Cosmin080/Oscilator-RC-cu-retea-Wien/P1_2024_431E_Oprea_Cosmin_OW_orCAD.pdf

UNIVERSITATEA NAȚIONALĂ DE ȘTIINȚĂ ȘI TEHNOLOGIE POLITEHNICA DIN BUCUREȘTI Facultatea de Electronică ,Telecomunicații și Tehnologia Informației

### Oscilator RC cu punte Wien

### Student: Oprea Cosmin

### Grupa:431E

### 1)Date de proiectare

- N=18
- Frecventa de oscilatie reglabila ,fo intre 9-54 [KHz]
- Sarcina la iesire RL:18 kΩ
- Amplitudinea de oscilatie la iesire – Vo: 0.74V
- Control automat al amplitudinii de oscilatie realizat cu TEC-J
- Domeniul temperaturilor de functionare: 0°C - 70°C
- Semnalizarea prezenței tensiunilor de alimentare cu diodă de tip LED

### 2)Schema bloc a circuitului

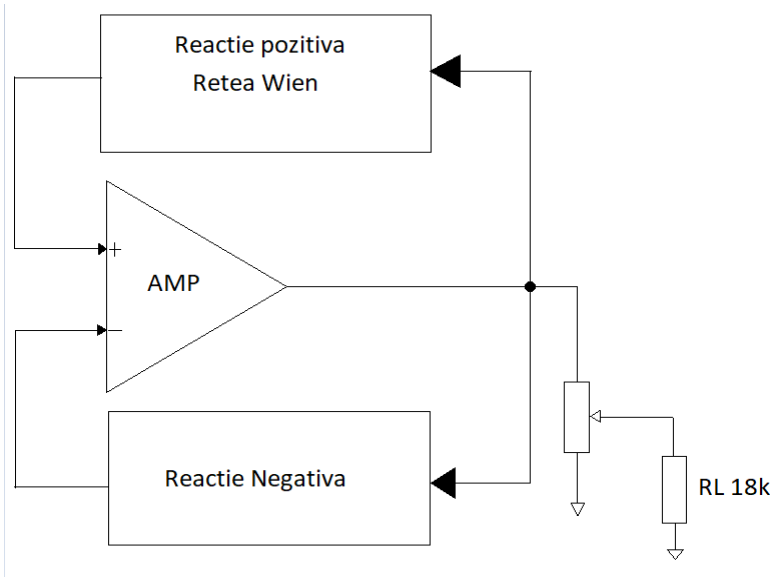
[picture p1: figure]

### 3)Schema oscilatorului

In figura se pot observa componentele oscilatorului:amplificatorul de baza, reactia negativa si puntea Wien.

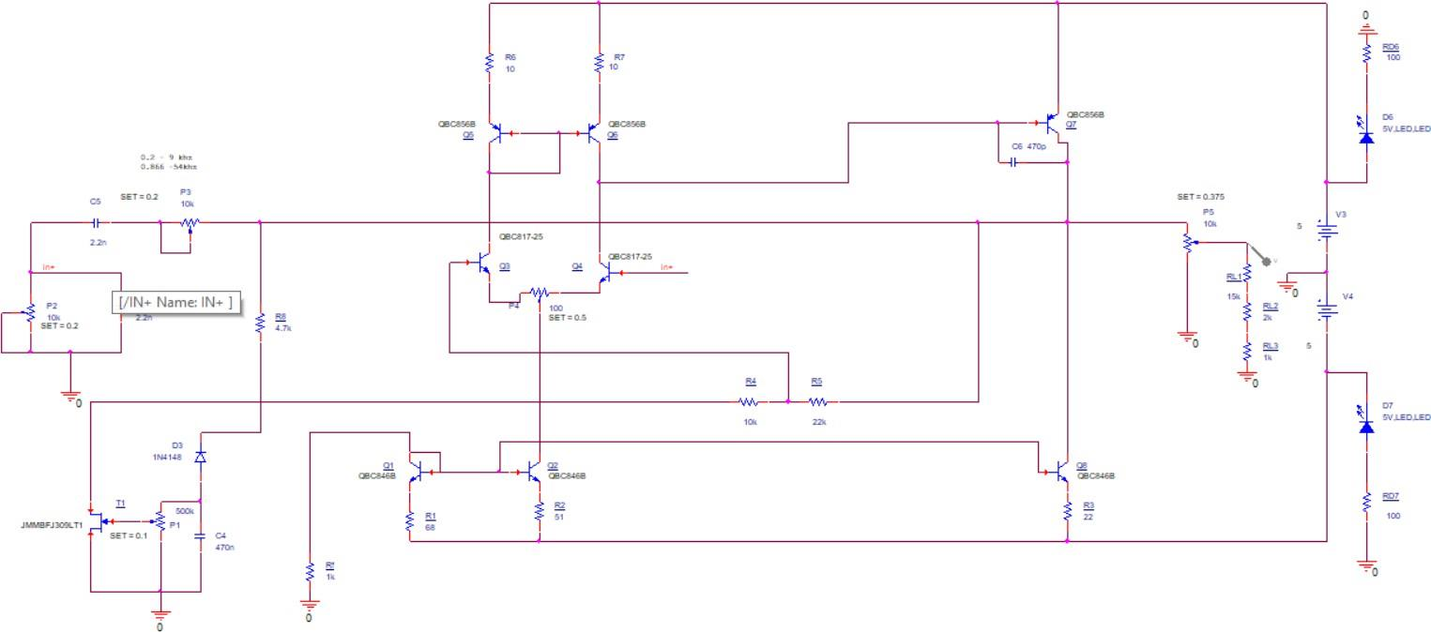
[picture p2: figure]

- Blocurile componente:
− Etaj diferential de intrare format din: Q3 si Q4.
− Etaj de castig in conexiune emitor comun,etaj de amplificare: Q7.
− Capacitate Miller utilizata pentru compensarea in frecventa a amplificatoarelor, manifestandu-se ca o crestere a capacitatii efective prin amplificare: C6.
− Controleaza amplitudinea oscilatiilor: P5.
− Controleaza frecventa de oscilatie: P2 si P3.
− Q5 si Q6 au rolul de a egala curentii pe cele 2 ramuri,Q5 fiind referinta de oglinda.
− P4 balanseaza curentii pentru etajul diferential
− Q8 sursa de curent pentru Q7(emitor comun)
− Curentul de referinta este generat pe latura cu rezista Rf

Proiectarea reactiei pozitive:

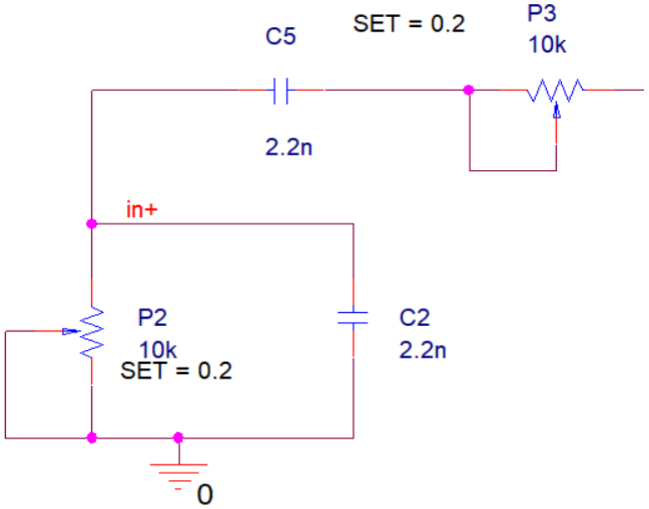
[picture p3: figure]

Formula cu care aflam valoarea frecventei este: fosc=1/(2πRC).

Valorile componentelor au fost alese pentru a acoperi intreaga gama de valori.

Proiectarea reactiei negative:

E constituita din rezistente R5, R4 si rezistenta canalului tranzistorului JFET – T1

Rezistenta canalului lui T1 este un parametru ce se modifica dinamic in functie de amplitudinea oscilatiilor la iesire.

Amplificarea = 1+(R5/(R4+Rds,T1))

4) Simularea oscilatorului
4.1) Punctul static de functionare calculat (teoretic)

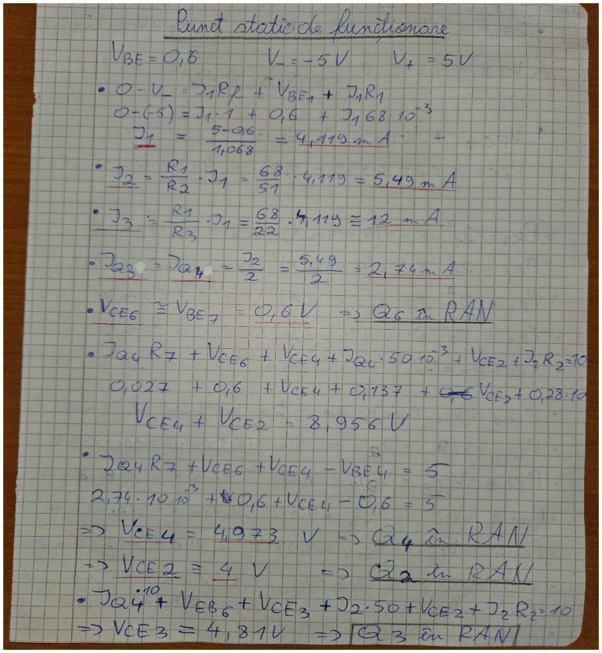
[picture p4: figure]

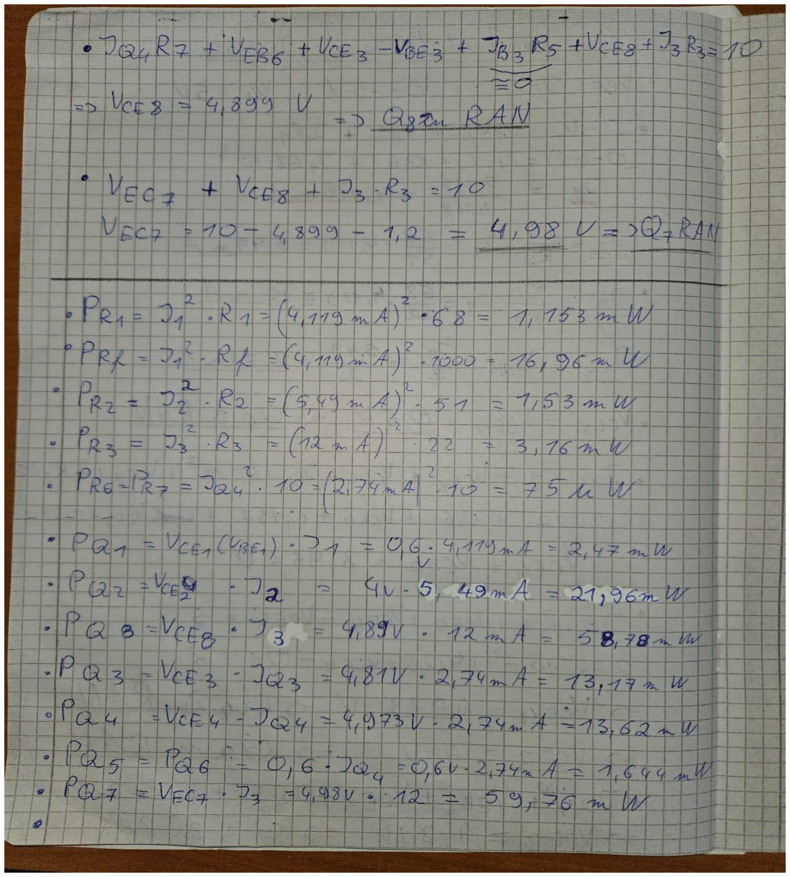
[picture p5: figure]

4.2) Punctul static de functionare simulat

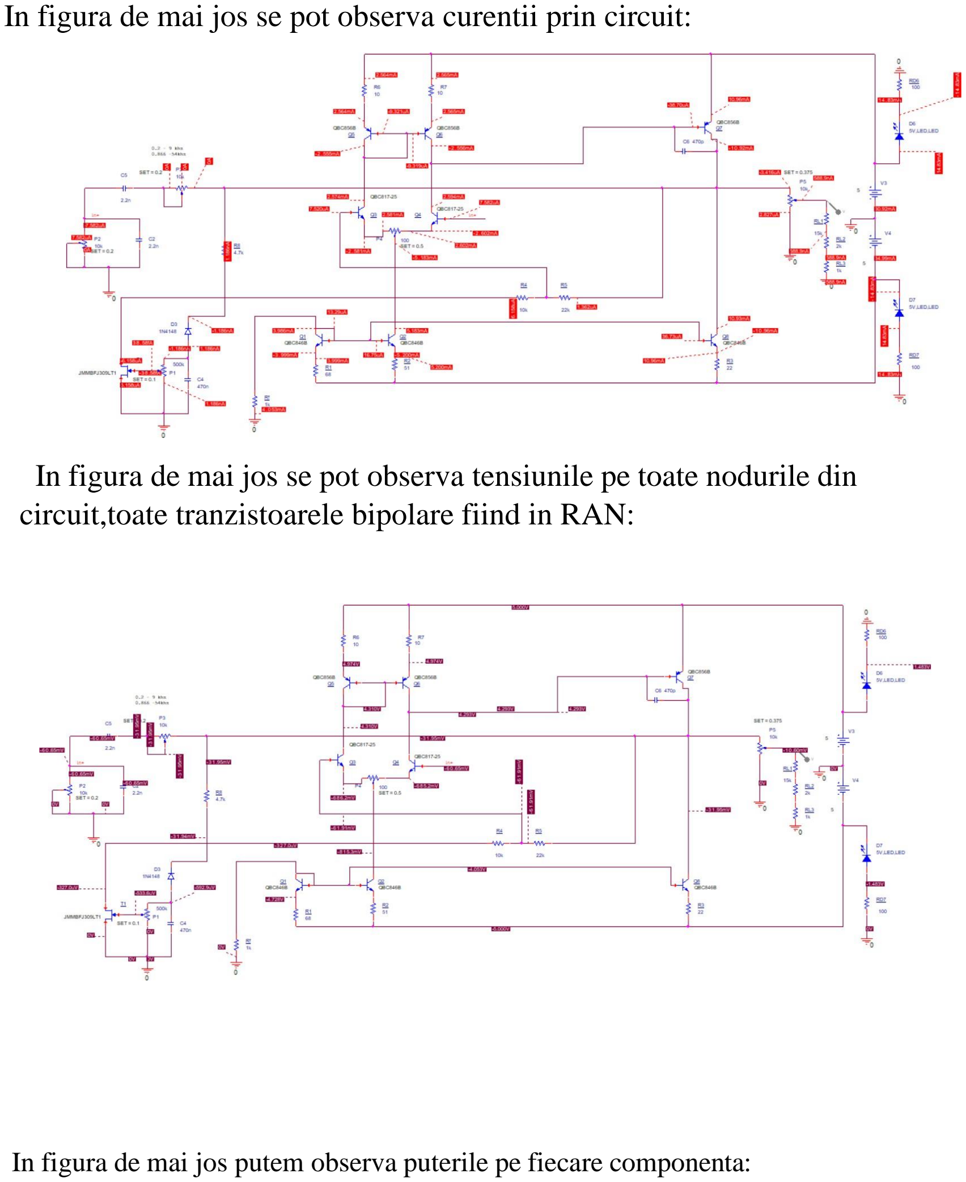
[picture p6: page 7]

In figura de mai jos se pot observa curentii prin circuit:

In figura de mai jos se pot observa tensiunile pe toate nodurile din circuit,toate tranzistoarele bipolare fiind in RAN:

In figura de mai jos putem observa puterile pe fiecare componenta:

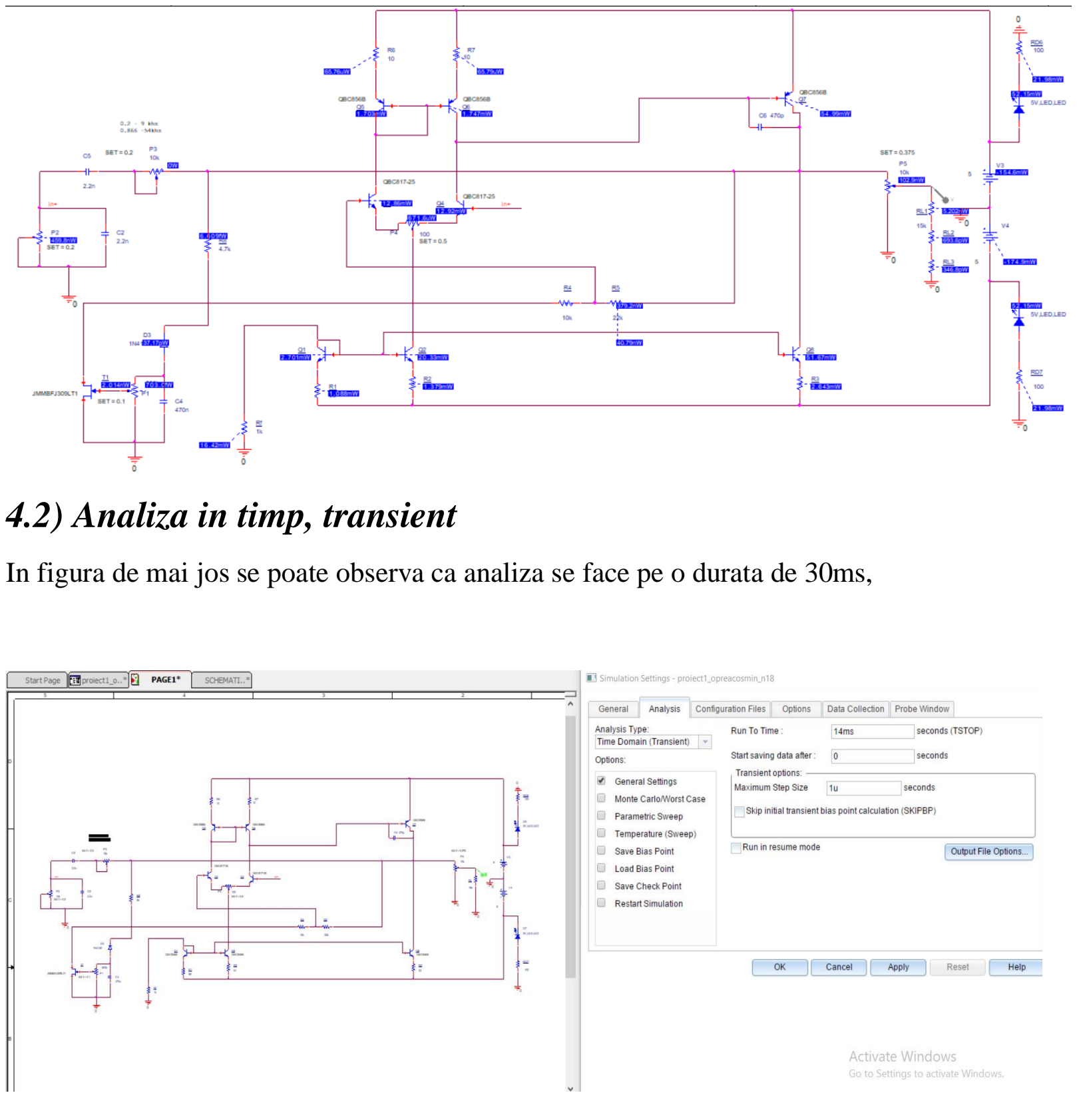
[picture p7: page 8]

4.2) Analiza in timp, transient

In figura de mai jos se poate observa ca analiza se face pe o durata de 30ms,

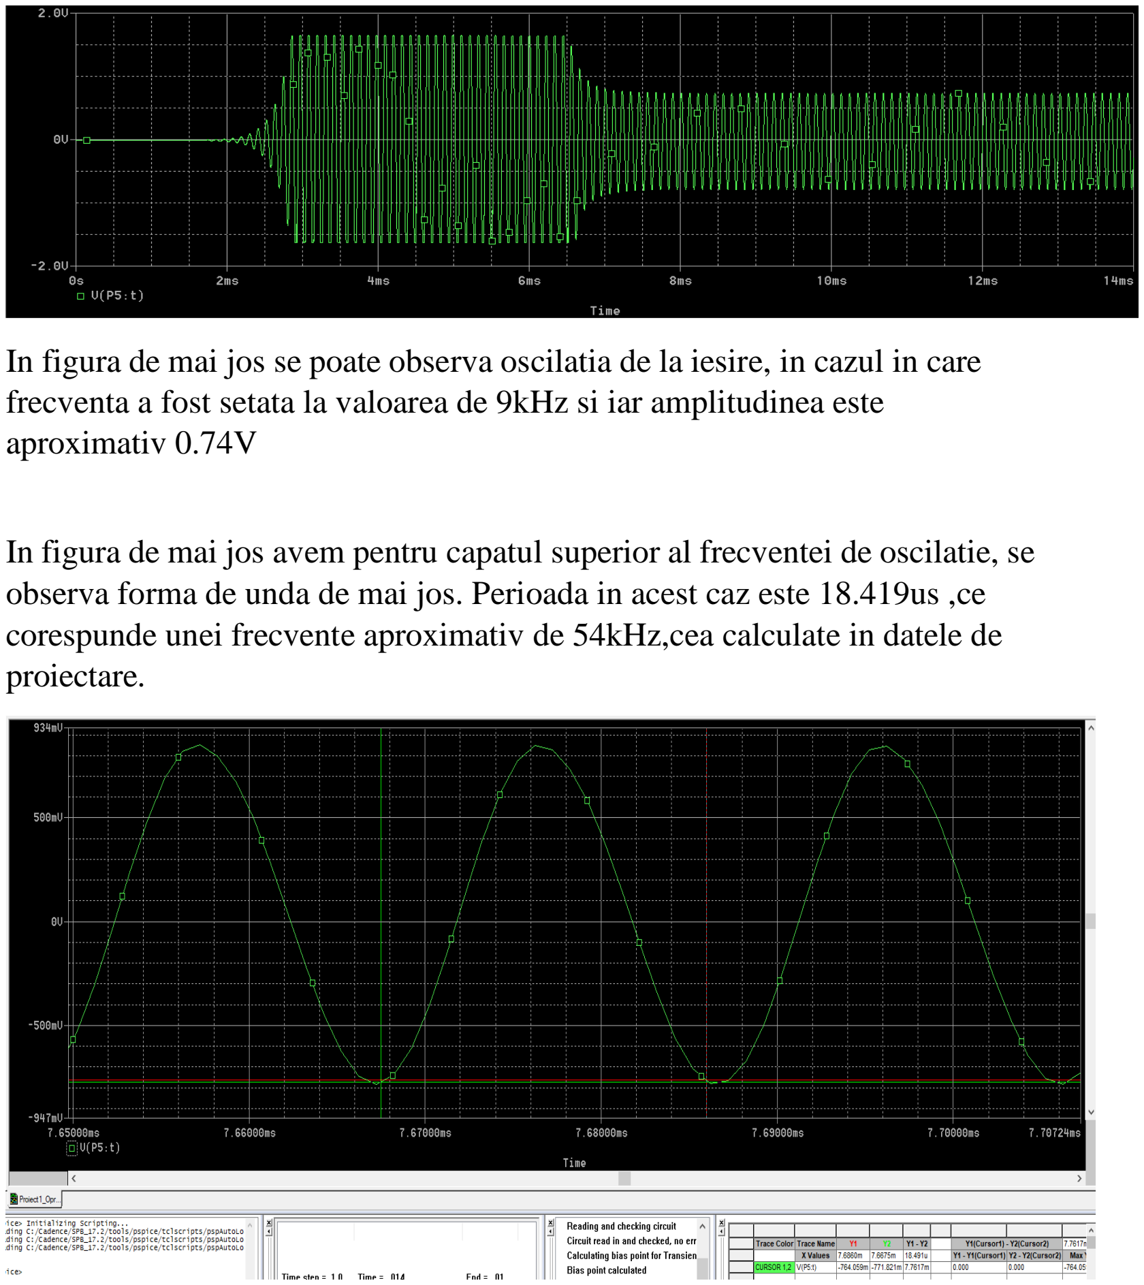
[picture p8: page 9]

In figura de mai jos se poate observa oscilatia de la iesire, in cazul in care frecventa a fost setata la valoarea de 9kHz si iar amplitudinea este aproximativ 0.74V

In figura de mai jos avem pentru capatul superior al frecventei de oscilatie, se observa forma de unda de mai jos. Perioada in acest caz este 18.419us ,ce corespunde unei frecvente aproximativ de 54kHz,cea calculate in datele de proiectare.

Domeniul temperaturilor de functionare este in intervalul 0°C - 70°C. Analiza tranzitorie la diferite temperaturi (0,25,50,70) este ilustrata mai jos, observandu-se ca oscilatorul asigura functionarea dorita pentru toate valorile de temperatura.

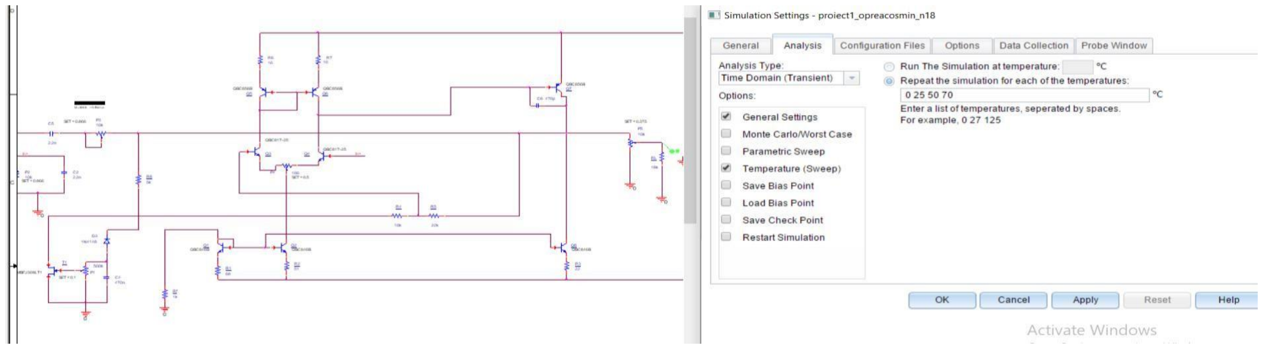
[picture p9: figure]
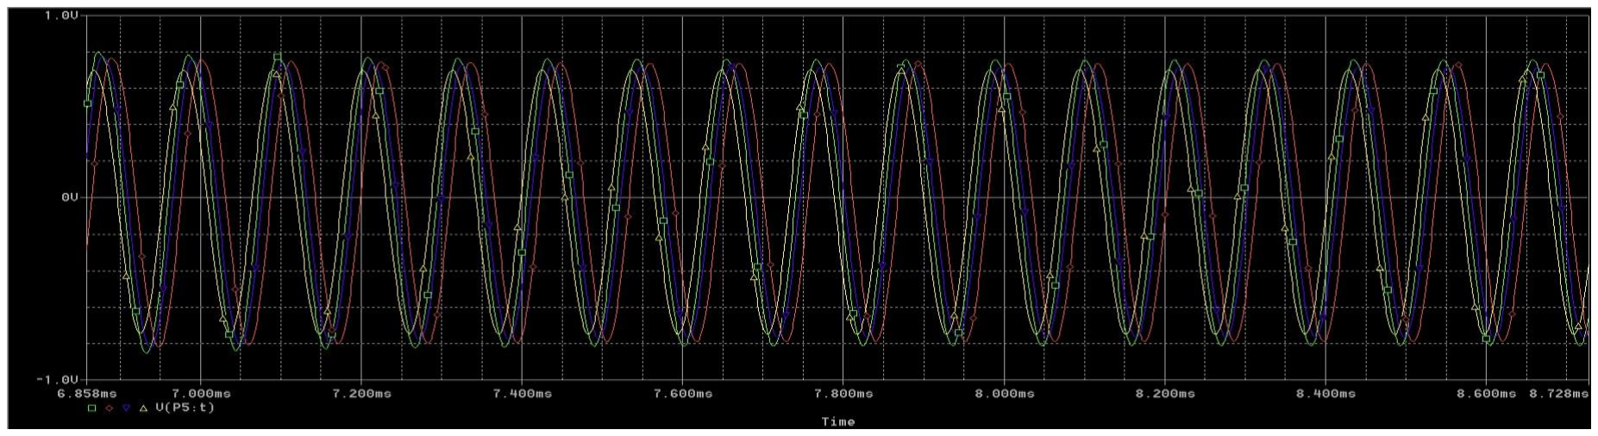
[picture p10: figure]
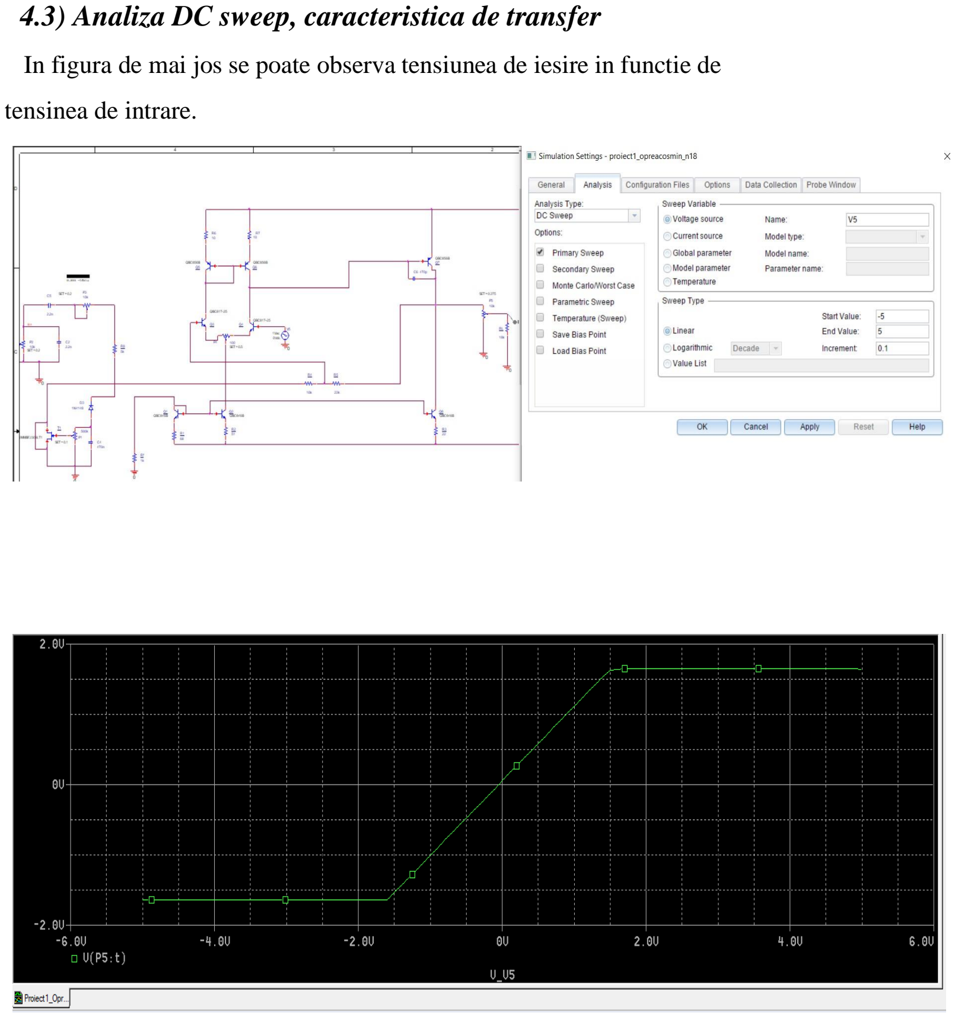
[picture p11: page 11]

4.3) Analiza DC sweep, caracteristica de transfer

In figura de mai jos se poate observa tensiunea de iesire in functie de

tensinea de intrare.

4.5) Diagramele Bode

Pentru a analiza stabilitatea circuitului, a fost realizata analiza AC.

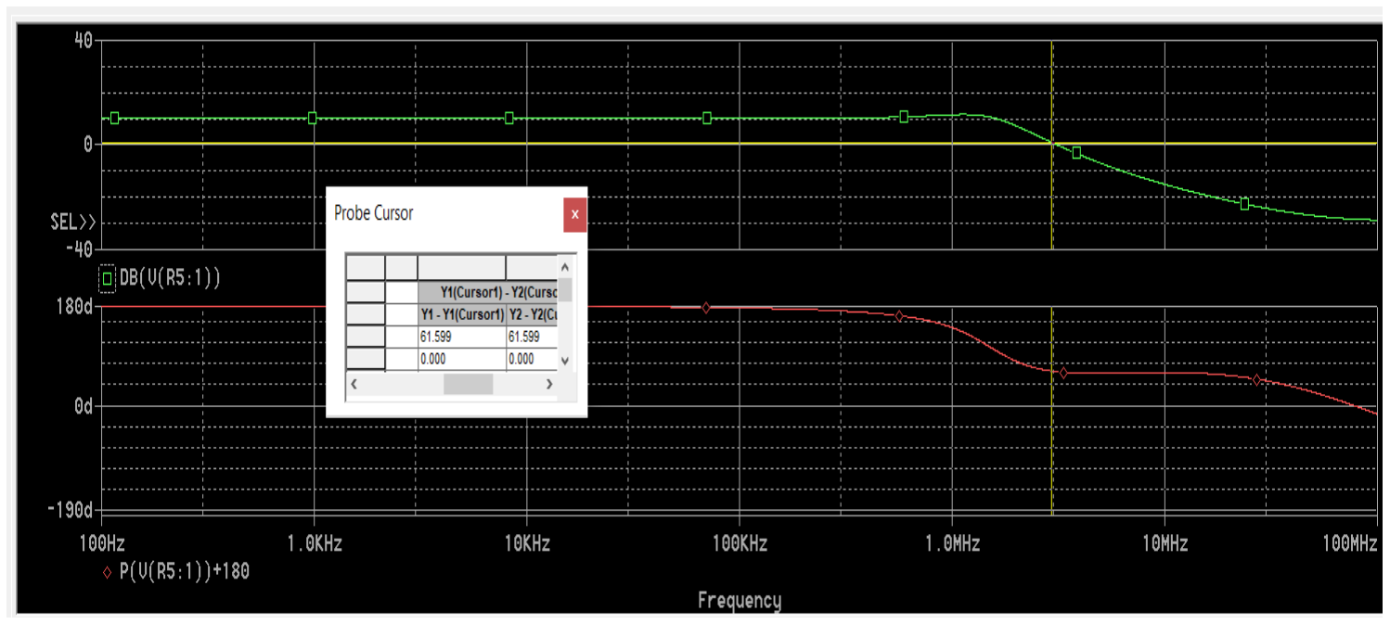
[picture p12: figure]

Valoarea de 61.6° a fazei sugerează o marjă de fază relativ mare, ceea ce este indicativ pentru o bună stabilitate.

## Fisiere Gerber

Top.art:

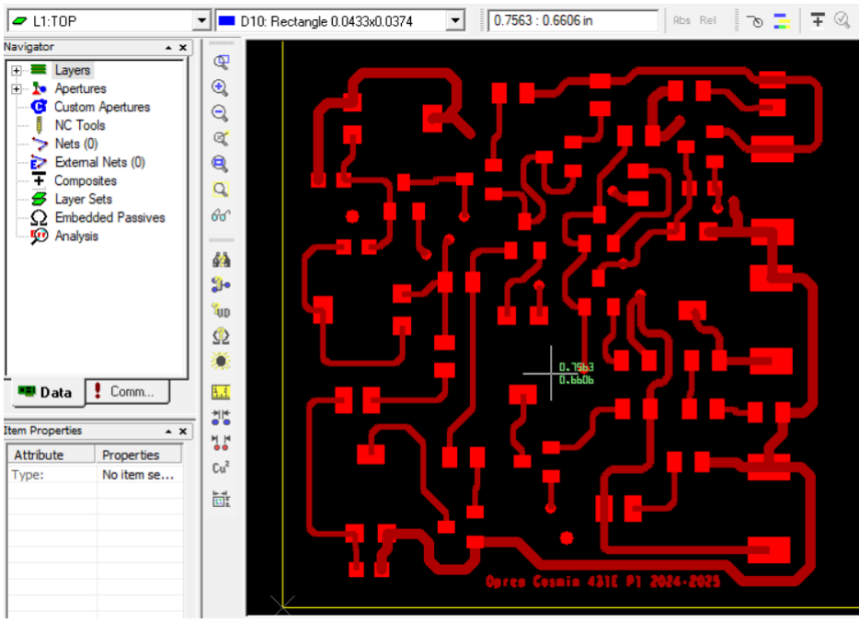
[picture p13: figure]

Bottom.art:

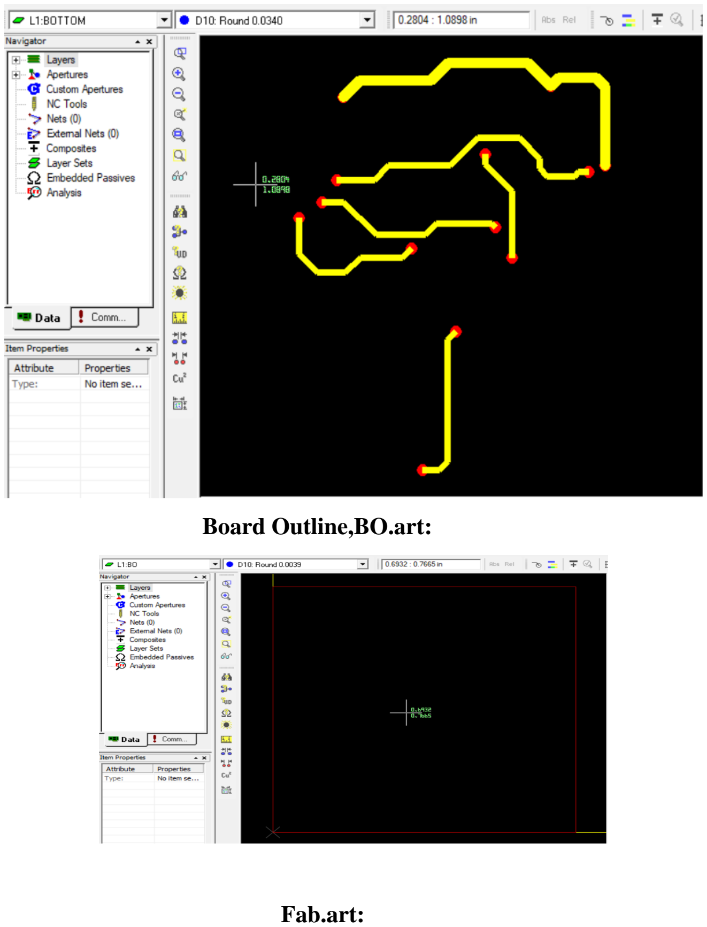
[picture p14: page 14]

Board Outline,BO.art:

Fab.art:

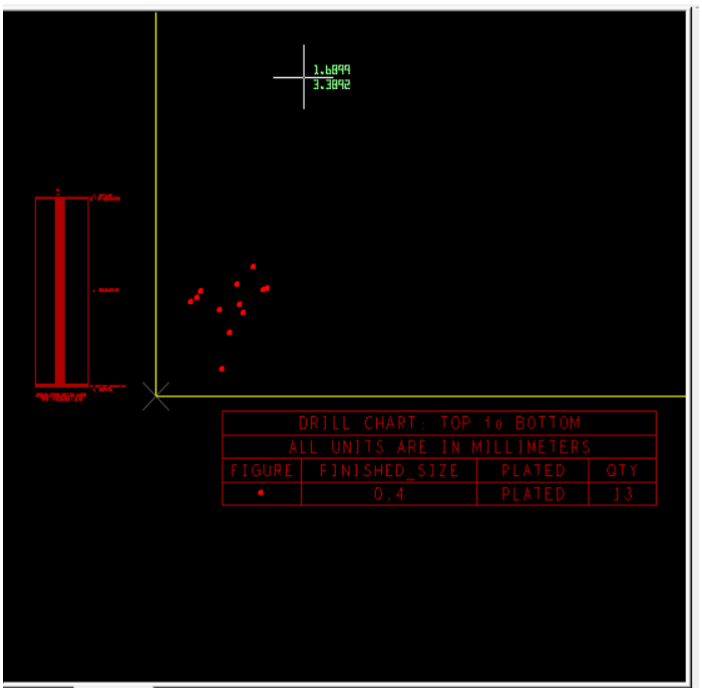
[picture p15: figure]

SMBOT.art:

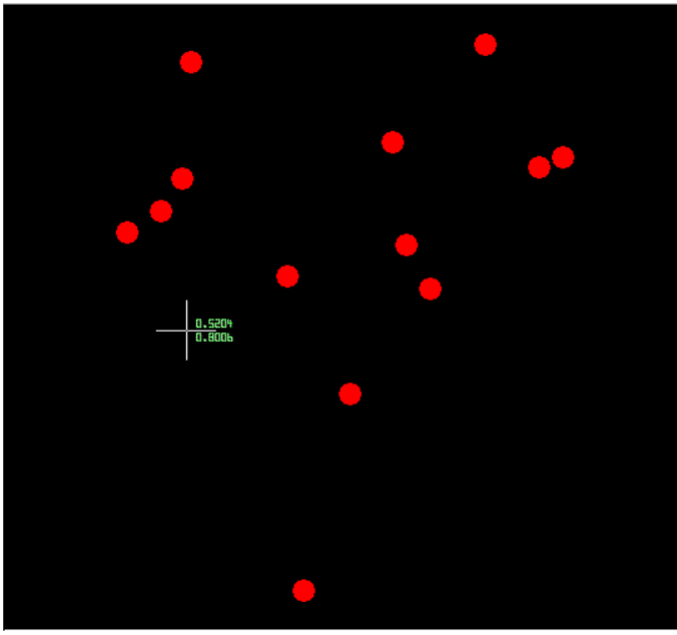
[picture p16: figure]

SMTOP.art:

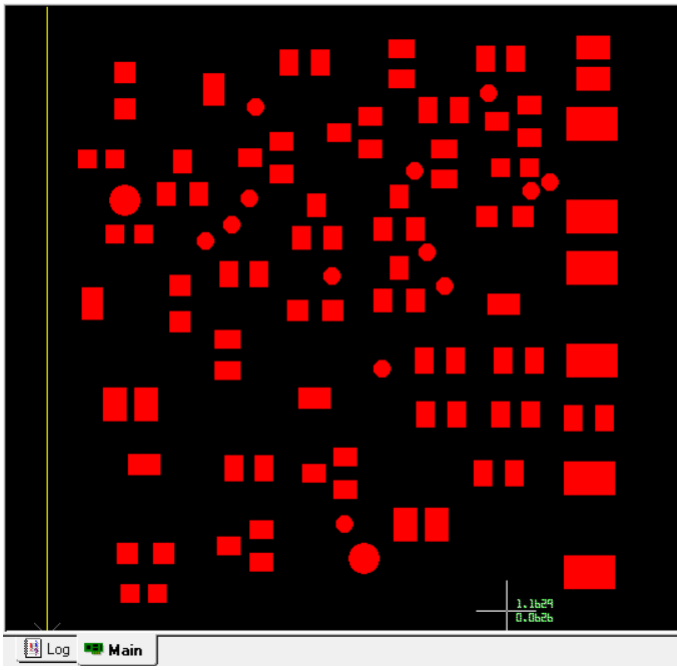
[picture p17: figure]

SPTOP.art:

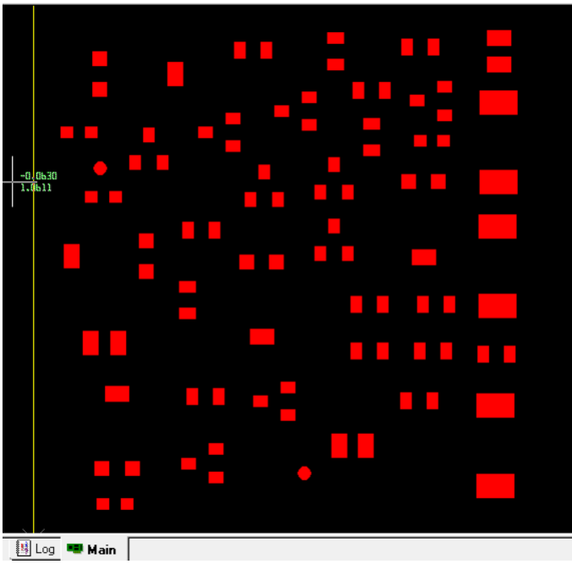
[picture p18: figure]

SSTOP.art:

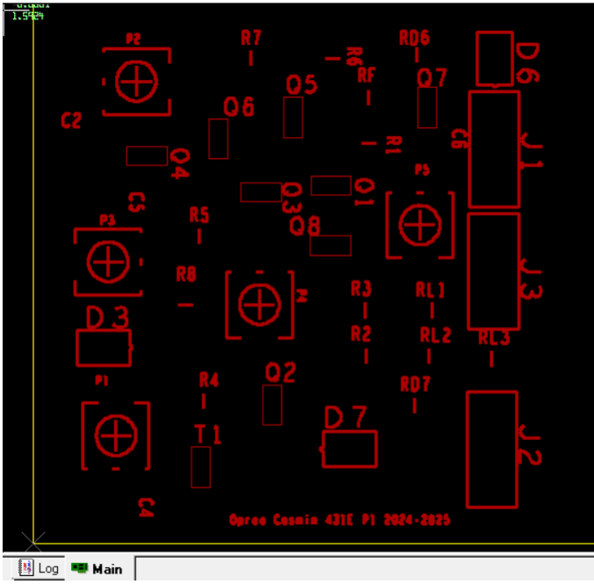
[picture p19: figure]
