Cosmin080/Oscilator-RC-cu-retea-Wien/Layout.jpg

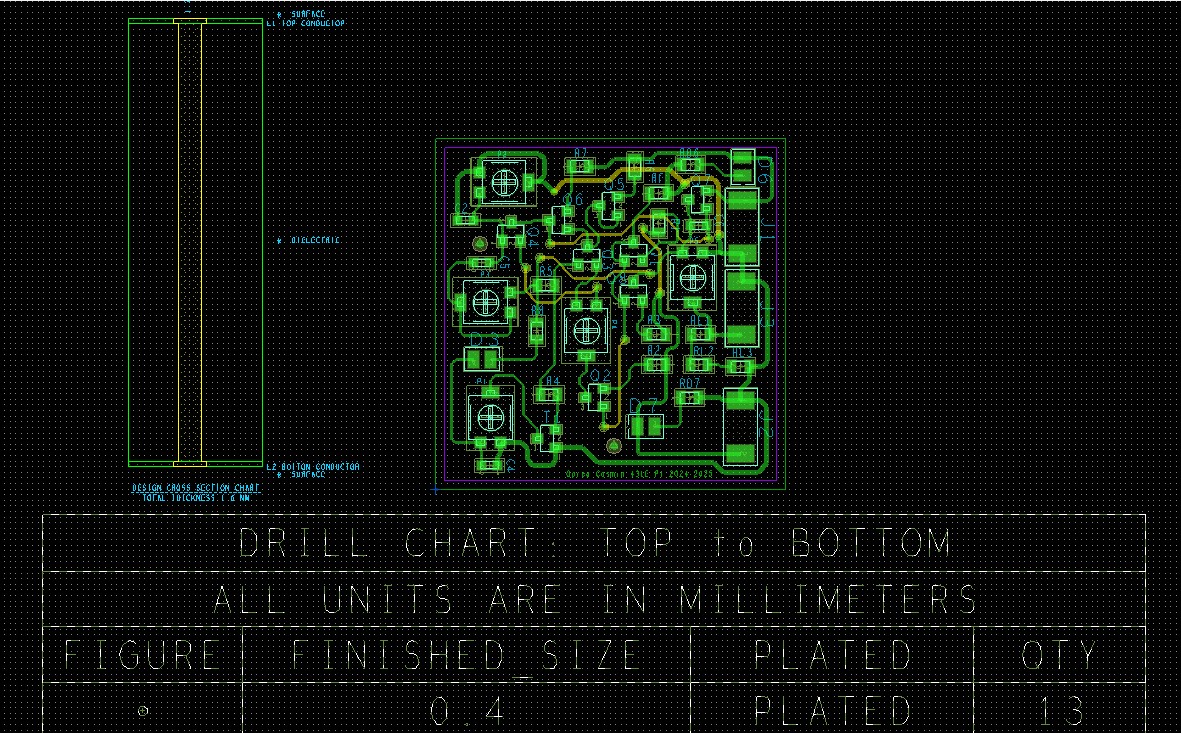
Layout.jpg
