Cosmin080/Oscilator-RC-cu-retea-Wien/(list of files, drawings)

Other design files:
PROIECT1_OPREACOSMIN_N18.DSN
Proiect1_OpreaCosmin_N18.opj
